liangbm3/Super-Fan/hardware/原理图.png

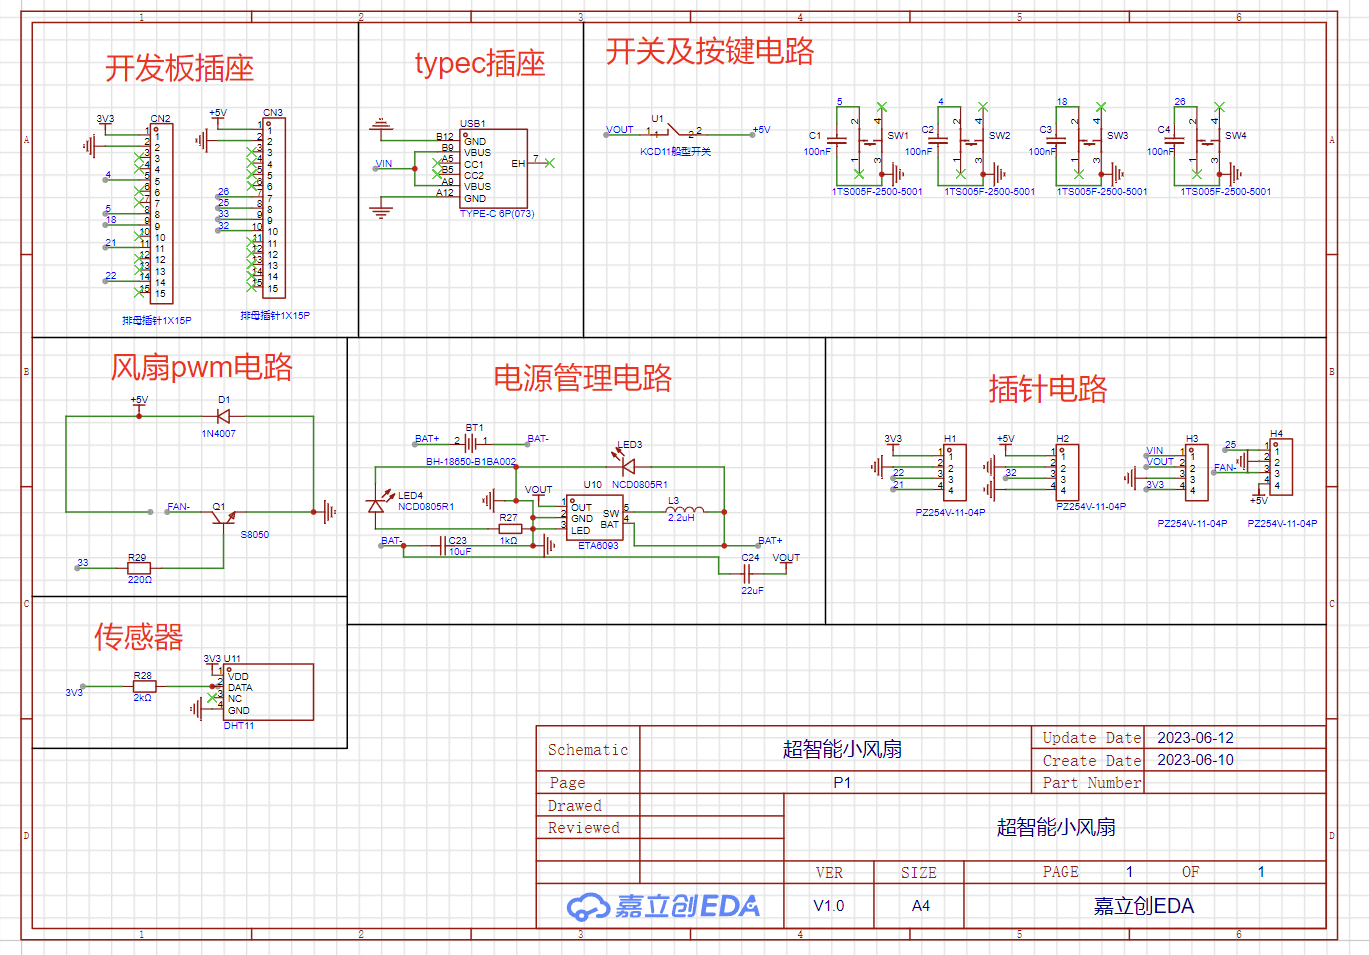
hardware/原理图.png
