liangbm3/Super-Fan/software/main/page.h

PROGMEM const uint8_t welcome_page[] =
{

  0x00, 0x00, 0x00, 0x00, 0x00, 0x00, 0x00, 0x00, 0x00, 0x00, 0x00, 0x00, 0x00, 0x00, 0x00, 0x00,
  0x00, 0x00, 0x00, 0x00, 0x00, 0x00, 0x00, 0x00, 0x00, 0x00, 0x00, 0x00, 0x00, 0x00, 0x00, 0x00,
  0x00, 0x00, 0x00, 0x00, 0x00, 0x00, 0x00, 0x00, 0x00, 0x00, 0x00, 0x00, 0x00, 0x00, 0x00, 0x00,
  0x00, 0x00, 0x00, 0x00, 0x00, 0x00, 0x00, 0x00, 0x00, 0x00, 0x00, 0x00, 0x00, 0x00, 0x00, 0x00,
  0x00, 0x00, 0x00, 0x00, 0x00, 0x00, 0x00, 0x00, 0x00, 0x00, 0x00, 0x00, 0x00, 0x00, 0x00, 0x00,
  0x00, 0x00, 0x00, 0x00, 0x00, 0x00, 0x00, 0x00, 0x00, 0x40, 0x00, 0x00, 0x00, 0x00, 0x00, 0x00,
  0x00, 0x00, 0x00, 0x00, 0x0C, 0xE0, 0xE0, 0x00, 0x40, 0x60, 0x00, 0xE0, 0x3F, 0x00, 0x00, 0x00,
  0x00, 0x00, 0x00, 0x1C, 0x04, 0x80, 0x3D, 0x1C, 0x20, 0xF0, 0x07, 0xFF, 0x60, 0x00, 0x00, 0x00,
  0x00, 0x00, 0x00, 0x37, 0xF6, 0x01, 0x08, 0x23, 0x90, 0xFF, 0x05, 0x81, 0xC0, 0x00, 0x00, 0x00,
  0x00, 0x00, 0x00, 0x20, 0x0E, 0x03, 0x08, 0x22, 0x08, 0x20, 0x00, 0x81, 0xC0, 0x00, 0x00, 0x00,
  0x00, 0x00, 0x00, 0x20, 0x03, 0x03, 0x08, 0x22, 0x0C, 0xF0, 0x01, 0x81, 0xC0, 0x00, 0x00, 0x00,
  0x00, 0x00, 0x00, 0x20, 0x01, 0x01, 0x08, 0x22, 0x9C, 0xFF, 0x03, 0x81, 0xC0, 0x00, 0x00, 0x00,
  0x00, 0x00, 0x00, 0x31, 0xB1, 0x01, 0x08, 0x22, 0x9A, 0x11, 0x06, 0xFF, 0xFF, 0x00, 0x00, 0x00,
  0x00, 0x00, 0x00, 0x12, 0x91, 0xE1, 0x09, 0x22, 0x9A, 0x10, 0x06, 0xC7, 0xC0, 0x00, 0x00, 0x00,
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
  0xB0, 0x01, 0x00, 0x00, 0x00, 0x00, 0x00, 0x00, 0xF0, 0x00, 0x00, 0x00, 0x00, 0x00, 0x00, 0x00,
  0x60, 0x00, 0x00, 0x00, 0x00, 0x00, 0x00, 0x00, 0x00, 0x00, 0x00, 0x00, 0x00, 0x00, 0x00, 0x00,
  0x00, 0x00, 0x00, 0x00, 0x00, 0x00, 0x00, 0x00, 0x00, 0x00, 0x00, 0x00, 0x00, 0x00, 0x00, 0x00,
};
