liangbm3/Super-Fan/(commit log)

2023-06-07 6.7更新
2023-07-02 2023.7.2，V1.0.0正式版
2023-07-02 Update README.md
    2023.7.2，正式版V1.0.1
2023-07-02 Update README.md
    2023.7.2，V1.0.1正式版
